Casterba60/DeskBot/DeskBot/Core/Src/main.c

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
/* Includes ------------------------------------------------------------------*/
#include "main.h"

/* USER CODE BEGIN Includes */
#include"motor.h"
#include "controller.h"
#include "joint.h"
#include "servo.h"
#include "limit_switch.h"
#include "uart.h"
/* USER CODE END Includes */

ADC_HandleTypeDef hadc1;

TIM_HandleTypeDef htim1;
TIM_HandleTypeDef htim2;
TIM_HandleTypeDef htim3;
TIM_HandleTypeDef htim4;
TIM_HandleTypeDef htim5;
TIM_HandleTypeDef htim9;
TIM_HandleTypeDef htim10;

UART_HandleTypeDef huart1;

/* USER CODE BEGIN PV */

motor_t motor_1;
motor_t motor_2;
motor_t motor_3;

PIDController motor1_pos;
PIDController motor1_vel;
PIDController motor2_pos;
PIDController motor2_vel;
PIDController motor3_pos;
PIDController motor3_vel;

joint shoulderYaw;
joint shoulderPitch;
joint elbowPitch;

LimitSwitch shoulderYawLMSW;
LimitSwitch shoulderPitchLMSW;
LimitSwitch elbowPitchLMSW;

bool calibrated[3] = { 0 };

JointAngles angles;
int32_t commands[5] = {0,0,0,90,0};


/* USER CODE END PV */

void SystemClock_Config(void);
static void MX_GPIO_Init(void);
static void MX_ADC1_Init(void);
static void MX_TIM1_Init(void);
static void MX_TIM2_Init(void);
static void MX_TIM3_Init(void);
static void MX_TIM4_Init(void);
static void MX_TIM5_Init(void);
static void MX_USART1_UART_Init(void);
static void MX_TIM10_Init(void);
static void MX_TIM9_Init(void);
/**
 * @brief Main program entry point.
 *
 * This function initializes all hardware peripherals, sets up motors,
 * PID controllers, and enters a loop that:
 * - Performs joint homing using limit switches
 * - Parses UART-based angle commands
 * - Updates joint setpoints and servo angles
 *
 * @retval int Always returns 0.
 */
int main(void)
{

  /* MCU Configuration--------------------------------------------------------*/

  /* Reset of all peripherals, Initializes the Flash interface and the Systick. */
  HAL_Init();

  /* Configure the system clock */
  SystemClock_Config();

  /* Initialize all configured peripherals */
  MX_GPIO_Init();
  MX_ADC1_Init();
  MX_TIM1_Init();
  MX_TIM2_Init();
  MX_TIM3_Init();
  MX_TIM4_Init();
  MX_TIM5_Init();
  MX_USART1_UART_Init();
  MX_TIM10_Init();
  MX_TIM9_Init();
  /* USER CODE BEGIN 2 */
  HAL_TIM_PWM_Start(&htim4,TIM_CHANNEL_1);
  HAL_TIM_PWM_Start(&htim4,TIM_CHANNEL_2);
  HAL_TIM_PWM_Start(&htim4,TIM_CHANNEL_3);
  HAL_TIM_PWM_Start(&htim4,TIM_CHANNEL_4);
  HAL_TIM_PWM_Start(&htim5,TIM_CHANNEL_1);
  HAL_TIM_PWM_Start(&htim5,TIM_CHANNEL_2);

  HAL_TIM_Encoder_Start(&htim1, TIM_CHANNEL_ALL);
  HAL_TIM_Encoder_Start(&htim2, TIM_CHANNEL_ALL);
  HAL_TIM_Encoder_Start(&htim3, TIM_CHANNEL_ALL);

  Motor_Init(&motor_1,&htim4,TIM_CHANNEL_1,TIM_CHANNEL_2);
  Motor_Init(&motor_2,&htim4,TIM_CHANNEL_3,TIM_CHANNEL_4);
  Motor_Init(&motor_3,&htim5,TIM_CHANNEL_1,TIM_CHANNEL_2);

  //PID_Init(PIDController* pid, float kp, float ki, float kd, float out_min, float out_max);
  PID_Init(&motor1_pos,0.4,0.062,40,750,15,-150,150);//max/min is ticks/ms
  PID_Init(&motor1_vel,0.4,0.085,60,350,3,-80,80); //output is PWM signal

  PID_Init(&motor2_pos,0.4,0.062,0,750,20,-100,100);//max/min is ticks/ms
  PID_Init(&motor2_vel,0.4,0.085,0,350,4,-80,80); //output is PWM signal

  PID_Init(&motor3_pos,0.4,0.062,0,750,20,-200,200);//max/min is ticks/ms
  PID_Init(&motor3_vel,0.4,0.085,0,350,4,-80,80); //output is PWM signal

  //Joint_Init(Joint* joint, motor* p_mot, TIM_HandleTypeDef* encoderHandle,
	//PIDController* pos_pid,PIDController* vel_pid);
  Joint_Init(&shoulderYaw,&motor_1,&htim1,&motor1_pos,&motor1_vel);
  Joint_Init(&shoulderPitch,&motor_2,&htim2,&motor2_pos,&motor2_vel);
  Joint_Init(&elbowPitch,&motor_3,&htim3,&motor3_pos,&motor3_vel);

  LimitSwitch_Init(&shoulderYawLMSW,GPIOC, GPIO_PIN_14);
  LimitSwitch_Init(&shoulderPitchLMSW,GPIOA,GPIO_PIN_11);
  LimitSwitch_Init(&elbowPitchLMSW,GPIOC,GPIO_PIN_15);

  HAL_TIM_Base_Start_IT(&htim10);
  servo_init_timer(&htim9);

  int8_t gripperServo = servo_add(GPIOA, 3);  // PA2 - Gripper
  int8_t wristServo = servo_add(GPIOA, 2);  // PA3 - Wrist

  UART_Init(&huart1);
  /* USER CODE END 2 */

  /* Infinite loop */
  /* USER CODE BEGIN WHILE */
  while (1)
  {
    /* USER CODE END WHILE */

    /* USER CODE BEGIN 3 */
	  while (!(calibrated[0] && calibrated[1] && calibrated[2])) {
		  // Loop until all flags are true
		  if(!calibrated[0])
		  {
			  calibrated[0] = Joint_Home(&shoulderYaw,&shoulderYawLMSW,1,60);
		  }
		  if(!calibrated[1])
		  {
			  calibrated[1] = Joint_Home(&shoulderPitch,&shoulderPitchLMSW,1,60);
		  }
		  if(!calibrated[2])
		  {
			  calibrated[2] = Joint_Home(&elbowPitch,&elbowPitchLMSW,-1,75);
		  }
	  }
	  UART_ProcessReceivedData(); // Non-blocking parse handler
	      if (UART_GetLatestAngles(&angles)) {
	    	  //27.125 encoder ticks/deg for base
	    	  //108.5 for the shoulder and elbow
	    	  //replace this with a IK solver in the future...
	    	  commands[0] = (int)13.56*angles.theta1;
	    	  commands[1] = -1*(int)54.25*angles.theta2;
	    	  commands[2] = (int)54.25*angles.theta3;
	    	  commands[3] = angles.theta4;
	    	  commands[4] = angles.theta5;
	    	  shoulderYaw.desired_position = commands[0];
	    	  shoulderPitch.desired_position = commands[1];
	    	  elbowPitch.desired_position = commands[2];
	    	  servo_set_angle(wristServo,commands[3]);
	    	  servo_set_angle(gripperServo,commands[4]);
	      }
  }
  /* USER CODE END 3 */
}

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
/* USER CODE BEGIN 4 */
/**
 * @brief Periodic interrupt callback from TIM10 and TIM9.
 *
 * TIM10: Triggers joint PID updates every 50 ms.
 * TIM9 : Triggers software PWM updates for servos.
 */
void HAL_TIM_PeriodElapsedCallback(TIM_HandleTypeDef *htim)
{
	if(htim->Instance == TIM10)
	{
		//PID CONTROL HERE
		Joint_Update(&shoulderYaw,50);
		Joint_Update(&shoulderPitch,50);
		Joint_Update(&elbowPitch,50);
	}
	if(htim->Instance == TIM9)
	{
		servo_update_tick();
	}
}
/* USER CODE END 4 */
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
