Casterba60/DeskBot/DeskBot/DeskBot.ioc

Mcu.UserName=STM32F411CEUx
PA0-WKUP.Signal=S_TIM5_CH1
PA1.Signal=S_TIM5_CH2
PA10.Signal=USART1_RX
PA11.Signal=GPIO_Input
PA12.Signal=GPIO_Input
PA13.Signal=SYS_JTMS-SWDIO
PA14.Signal=SYS_JTCK-SWCLK
PA15.Signal=USART1_TX
PA2.Signal=GPIO_Output
PA3.Signal=GPIO_Output
PA5.Signal=S_TIM2_CH1_ETR
PA6.Signal=ADCx_IN6
PA7.Signal=ADCx_IN7
PA8.Signal=S_TIM1_CH1
PA9.Signal=S_TIM1_CH2
PB0.Signal=ADCx_IN8
PB1.Signal=ADCx_IN9
PB10.Signal=GPIO_Input
PB2.Signal=GPIO_Input
PB3.Signal=S_TIM2_CH2
PB4.Signal=S_TIM3_CH1
PB5.Signal=S_TIM3_CH2
PB6.Signal=S_TIM4_CH1
PB7.Signal=S_TIM4_CH2
PB8.Signal=S_TIM4_CH3
PB9.Signal=S_TIM4_CH4
PC13-ANTI_TAMP.Signal=GPIO_Output
PC14-OSC32_IN.Signal=GPIO_Input
PC15-OSC32_OUT.Signal=GPIO_Input
