Casterba60/DeskBot/DeskBot/Core/Src/joint.c

/*
 * joint.c
 *
 *  Created on: Jun 8, 2025
 *      Author: cole
 */

#include "joint.h"

/**
 * @brief Reads encoder position and calculates velocity for the joint.
 *
 * Applies overflow correction for 16-bit timer. First read is ignored for velocity.
 *
 * @param joint Pointer to the joint object.
 * @param dt_ms Time delta since last update in milliseconds.
 */
void Read_Encoder(joint* joint, int dt_ms)
{

	int curr_count = __HAL_TIM_GET_COUNTER(joint->encoderHandle);
	int delta = curr_count - joint->previousEncoderCount;

	 // Handle 16-bit counter overflow/underflow
	if (delta > 32767) {
		delta -= 65536;
	}
	else if (delta < -32768) {
		delta += 65536;
	}
	if (!joint->encoder_init) {
		delta = 0;  // Avoid spike on first call
	    joint->encoder_init = 1;
	}

	joint->previousEncoderCount = curr_count;

	joint->actual_velocity = delta / dt_ms;
	joint->actual_position = joint->actual_position + delta;
}

/**
 * @brief Initializes a joint with motor, encoder, and PID configuration.
 *
 * Resets all control variables and enables the joint.
 *
 * @param joint Pointer to the joint object.
 * @param p_mot Pointer to the motor object.
 * @param encoderHandle Timer handle for quadrature encoder input.
 * @param pos_pid Pointer to position PID controller config.
 * @param vel_pid Pointer to velocity PID controller config.
 */
void Joint_Init(joint* joint, motor_t* p_mot, TIM_HandleTypeDef* encoderHandle,
		PIDController* pos_pid,PIDController* vel_pid)
{
	joint->position_pid = *pos_pid;
	joint->velocity_pid = *vel_pid;

	joint->desired_position = 0;
	joint->desired_velocity = 0;
	joint->actual_position = 0;
	joint->actual_velocity = 0;
	joint->control_output = 0;

	joint->p_mot = p_mot;
	joint->encoderHandle = encoderHandle;
	joint->enable = 1;

	joint->previousEncoderCount = 0;
	joint->encoder_init = 0;
}

/**
 * @brief Runs the joint control update for one time step.
 *
 * Combines outer-loop (position) and inner-loop (velocity) PID control.
 * Outer loop runs every 2 updates for efficiency.
 *
 * @param joint Pointer to the joint object.
 * @param dt_ms Time delta since last update in milliseconds.
 */
void Joint_Update(joint* joint, int dt_ms)
{
	static int outer_loop_counter = 0;

	Read_Encoder(joint,dt_ms); //gets position and velocity

	if(!joint->enable){
		return;
	}
	//run outer loop every 10 calls
	if(outer_loop_counter == 0)
	{
		joint->desired_velocity = PID_Update(&joint->position_pid,
											joint->desired_position,
											joint->actual_position,10*dt_ms);
	}
	//inner loop
	joint->control_output = PID_Update(&joint->velocity_pid,
										joint->desired_velocity,
										joint->actual_velocity,dt_ms);
	Set_Duty(joint->p_mot,joint->control_output);

	outer_loop_counter++;
	if(outer_loop_counter >= 2){ //ratio of outer loop to inner loop control
		outer_loop_counter = 0;
	}
}

/**
 * @brief Homes the joint using a limit switch and resets encoder.
 *
 * Drives motor at fixed speed until limit switch is triggered, then zeroes the position.
 *
 * @param joint Pointer to the joint object.
 * @param limswitch Pointer to the limit switch to use.
 * @param direction Direction to move motor during homing (-1 or +1).
 * @param speed Speed to apply while homing.
 * @return true if homed successfully, false if still homing.
 */
bool Joint_Home(joint* joint,LimitSwitch* limswitch, int direction, int speed)
{
	joint->enable = 0;
	// 1. Set the motor to move in a fixed direction (e.g., -1 or 1)
	Set_Duty(joint->p_mot, direction * speed);

	// 2. Continuously check the limit switch
	if (LimitSwitch_IsTriggered(limswitch)) {
		Set_Duty(joint->p_mot, 0);             // Stop motor
		joint->actual_position = 0;                 // Zero the software encoder position
		__HAL_TIM_SET_COUNTER(joint->encoderHandle, 0); // Reset hardware encoder
		joint->encoder_init = 0;             // Reset filtering state
		joint->desired_position = 0;
		joint->enable = 1;
		return true;  // Homed successfully
	}

	return false;  // Still homing
}
