Casterba60/DeskBot/(commit log)

2025-06-02 Initial Proj Commit
    Positional Control of DC motors
2025-06-09 I really should push my commits more often
    Forward Kinematics done in matlab
    Refactored controller logic
    Updated to cascading controller for each joint
2025-06-10 individual motor control - tuned and working
    DC motors can now be commanded to angles individually, PID controllers are tuned but can still be somewhat improved
2025-06-12 demo code
    No IKSolver yet, but robot arm is commanded via uart, each joint angle can be commanded
2025-06-12 matlab inverse kinematics work
2025-06-12 inverse kinematic solver
2025-06-14 Fix case: rename Docs to docs
