Casterba60/DeskBot/Docs/media/DeskBotActual.jpg

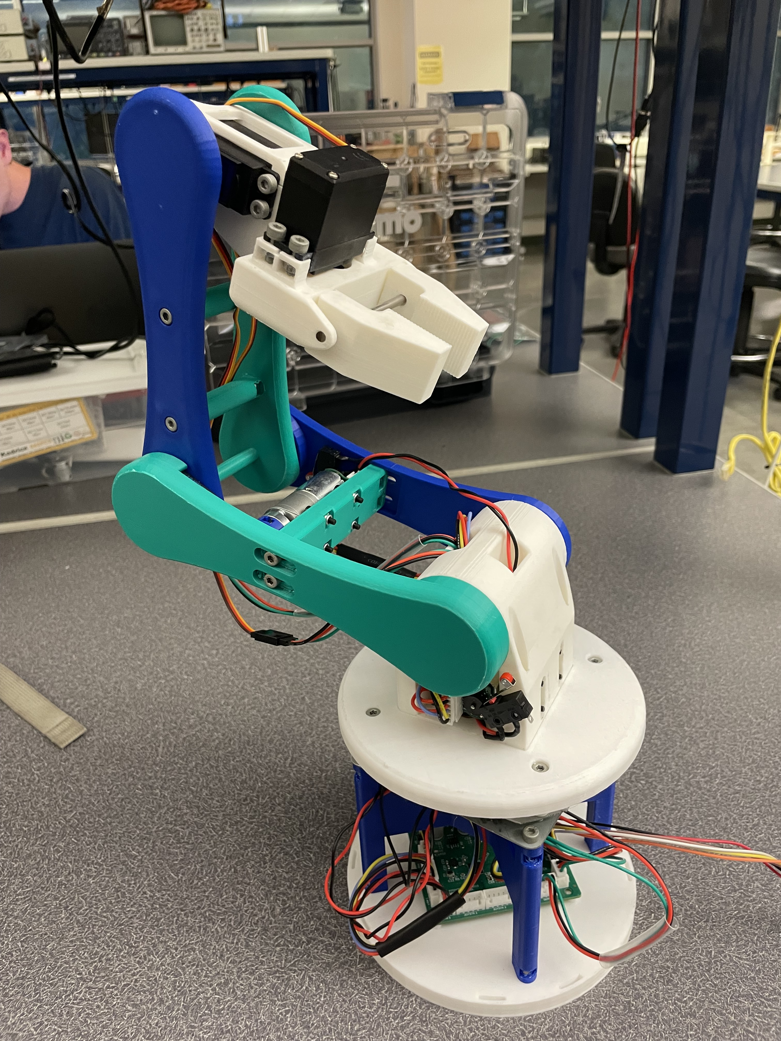
[picture p1: docs/media/DeskBotActual.jpg]
Docs/media/DeskBotActual.jpg
